Davide6414/Color_toy_fidget_stack/stl/piatto_di_prova.stl

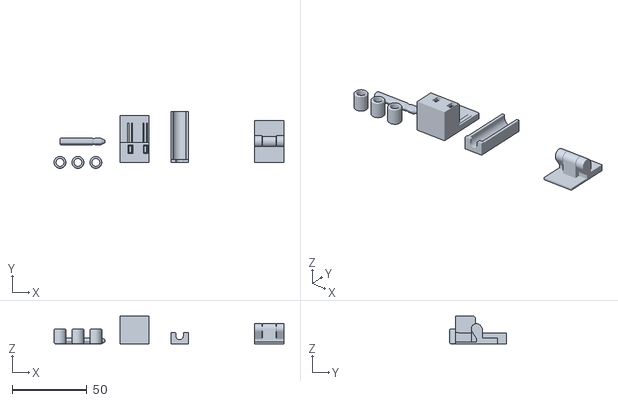
[picture p5: CAD file, 2026-11-06]
stl/piatto_di_prova.stl
153.8 x 38.0 x 18.5
