Davide6414/Color_toy_fidget_stack/stl/ordina-colori-bambu.3mf

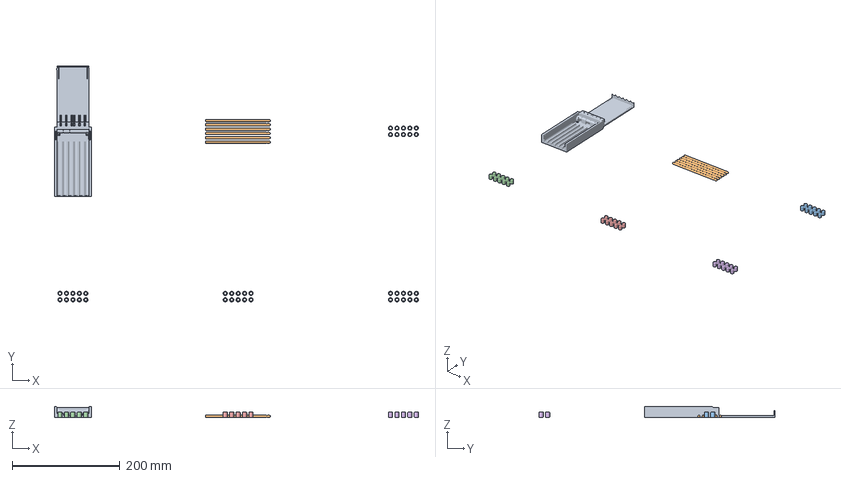
[picture p6: CAD file, 2026-11-06]
stl/ordina-colori-bambu.3mf
676.6 x 438.6 x 20.0 mm
scatola
aste_x6
anelli_rosa
anelli_verde
anelli_giallo
anelli_blu
