Davide6414/Color_toy_fidget_stack/stl/stampa_prova.stl

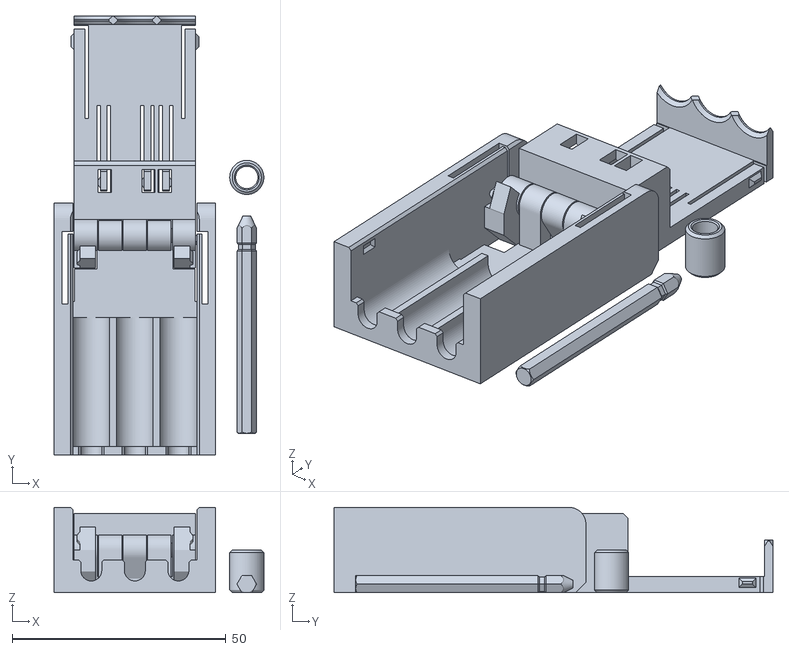
[picture p7: CAD file, 2026-11-06]
stl/stampa_prova.stl
49.1 x 102.8 x 20.0
