Davide6414/Color_toy_fidget_stack/stl/scatola.stl

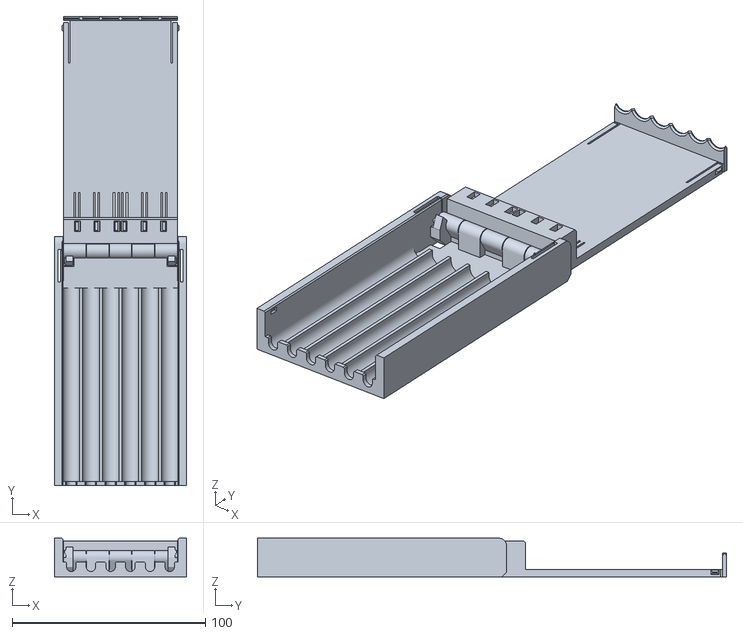
[picture p8: CAD file, 2026-11-06]
stl/scatola.stl
68.4 x 242.8 x 20.0
