Davide6414/Color_toy_fidget_stack/stl/aste_x6.stl

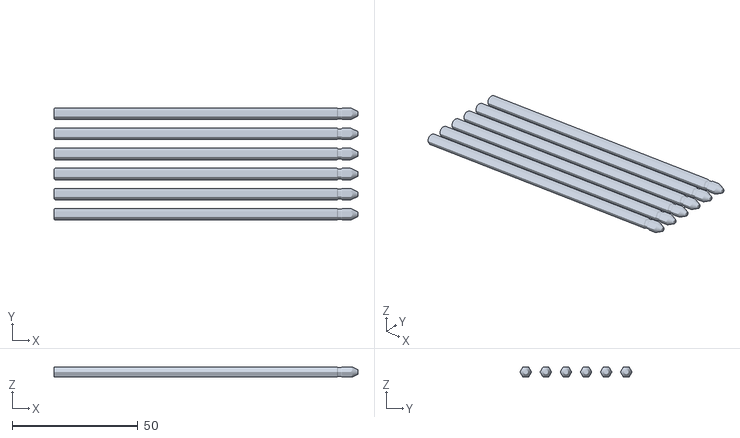
[picture p9: CAD file, 2026-11-06]
stl/aste_x6.stl
121.0 x 44.6 x 4.00
