Davide6414/Color_toy_fidget_stack/stl/asta.stl

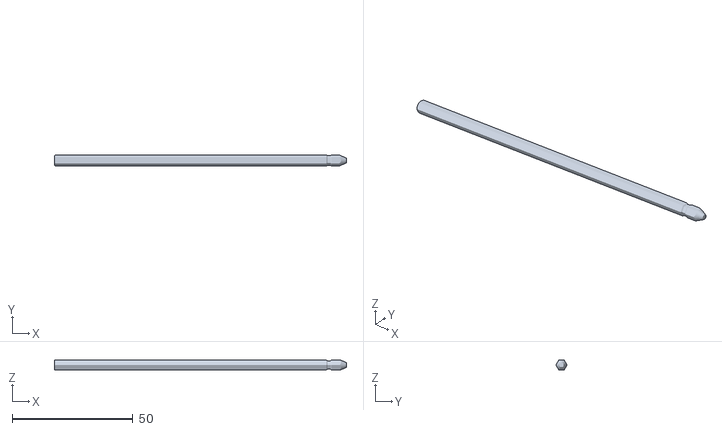
[picture p10: CAD file, 2026-11-06]
stl/asta.stl
121.0 x 4.62 x 4.00
