Davide6414/Color_toy_fidget_stack/stl/anello.stl

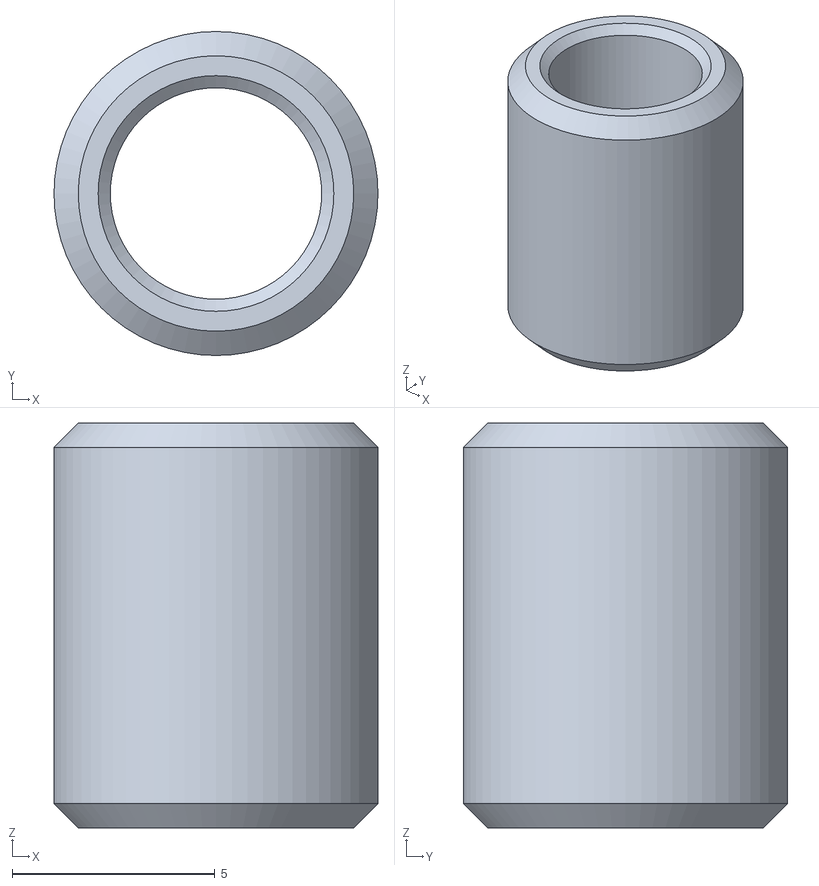
[picture p11: CAD file, 2026-10-28]
stl/anello.stl
8.00 x 8.00 x 10.0
