Davide6414/Color_toy_fidget_stack/stl/anelli_x10.stl

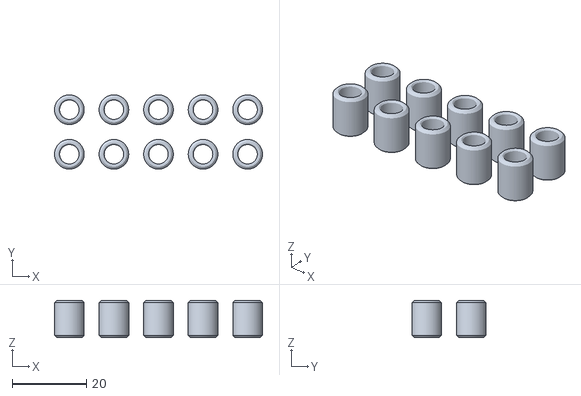
[picture p12: CAD file, 2026-10-28]
stl/anelli_x10.stl
56.0 x 20.0 x 10.0
