Davide6414/Color_toy_fidget_stack/(commit log)

2026-10-28 Progetto Color Fidget Stack: modelli 3D parametrici, STL, animazioni e sito Pages
    - Geometria CSG (manifold-3d) dei 5 pezzi: base con mozzo scanalato,
    tre dischi traslucidi CMY con bracci elastici a scatto, cappuccio con
    perno a 4 alette a scatto. Stesso codice nel browser e in Node.
    - STL pronti in stl/ (orientamento di stampa) e zip con tutti i pezzi.
    - Sito three.js: vista montata/esplosa, sezione, dischi trascinabili con
    clic, miscela sottrattiva dei colori, animazioni del funzionamento di
    ogni parte, parametri di stampa regolabili con export STL.
    - tools/check.mjs verifica solidi validi, assenza di compenetrazioni e che
    dentini e alette facciano presa; gira anche nel workflow.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
    [01_base.stl, 02_disco_giallo.stl, 03_disco_magenta.stl, 04_disco_ciano.stl, 05_cappuccio.stl]
2026-10-28 Gioco ordina-colori: scatola print in place, aste, anelli, animazioni e partita
    Sostituisce il prototipo precedente con il progetto delle specifiche:
    - geometria parametrica (manifold-3d) di scatola print in place con
    cerniera a metà altezza, 6 binari a U, tacche frontali, barra con sedi
    esagonali solidale al coperchio, fermo magnetico a 90° con una sola
    pausa di stampa e linguette elastiche di chiusura;
    - 40 anelli e 6 aste esagonali, piatti di stampa per la P1S e piatto di
    prova;
    - logica di gioco con regole ufficiali, agitata e risolutore (worker);
    - viewer three.js con cinematica di coperchio, aste e anelli, sezione,
    raggi X, piatti di stampa, animazioni d'uso e dei pezzi, pa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
    [01_base.stl, 02_disco_giallo.stl, 03_disco_magenta.stl, 04_disco_ciano.stl, 05_cappuccio.stl, anelli_x10.stl, anello.stl, asta.stl]
2026-10-28 Stampa prova: scatola mini a misura vera con un'asta e un anello in un piatto
    La stessa scatola con 3 binari da 3 anelli (37,8 x 55 x 20 mm, ~30 g), un'asta
    da 47 mm e un anello, tutto su un piatto da 49 x 95 mm. Giochi, cerniera,
    linguette, tacche, sedi e magneti restano a misura vera: in scala 1:2 l'asta
    sarebbe un esagono da 2 mm e i magneti 6 x 3 non entrerebbero nelle pareti.
    - Pulsante "Stampa prova" in alto, scheda in Pezzi, lista di controllo in Stampa
    e piatto nella vista dei piatti di stampa.
    - npm test verifica anche la scatola mini (predefiniti e cursori agli estremi)
    e il suo piatto; il carico di anelli nelle verifiche segue la capienza.
    - stl/stampa_prova.stl e zip aggiorn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
    [stampa_prova.stl]
2026-10-28 Correzioni dalla revisione: anelli sfilabili a 90°, magneti, nervature, sbalzi
    - La gonna frontale parte più in alto (z 9,8): a 90° gli anelli si
    sfilano dalla cima delle aste senza toccarla.
    - Sedi dei magneti del coperchio sottratte dopo l'unione (prima la
    nocca esterna le riempiva a metà).
    - Magneti del fermo a 8,9 mm dall'asse invece di 5,2 (coppia di tenuta
    circa tripla), pausa unica a Z 6,8.
    - Tre nervature di schiacciamento triangolari per sede: le aste non
    escono nel trasporto. Parametro regolabile, presenti anche nel
    piatto di prova.
    - Nocche del coperchio a inviluppo convesso e smussi a 45 gradi: nessuno
    sbalzo orizzontale in stampa (verificato).
    - Numero di anelli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
    [piatto_di_prova.stl, scatola.stl]
2026-11-06 Coperchio: aste a scatto, archi nella gonna, fermo a 90° senza magneti, progetto 3MF
    - Sedi da 12 mm: aste dritte a 90° (1,6–1,8° di inclinazione massima).
    - Archi nella gonna frontale sopra ogni tacca: a 90° gli anelli escono dalla
    coda delle aste senza toccare il coperchio.
    - Scatto delle aste nella sede: linguetta nel coperchio con pilastrino e
    dentino a 35°, gola esagonale sull'asta (cursore "Scatto aste").
    - Fermo a scatto a 90° al posto dei magneti: linguetta nella parete con un
    dentino che fa da battuta rigida, rilievo sotto la guancia che scatta nei
    due versi, passaggio unico dalla stampa a 180°. Niente pausa né magneti.
    - Tacche con invito a 45° in cima.
    - Progett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
    [asta.stl, aste_x6.stl, ordina-colori-bambu.3mf, piatto_di_prova.stl, scatola.stl, stampa_prova.stl]
